locky-z/Curve-Tracer/2019/PIC/IMG_4324.JPG

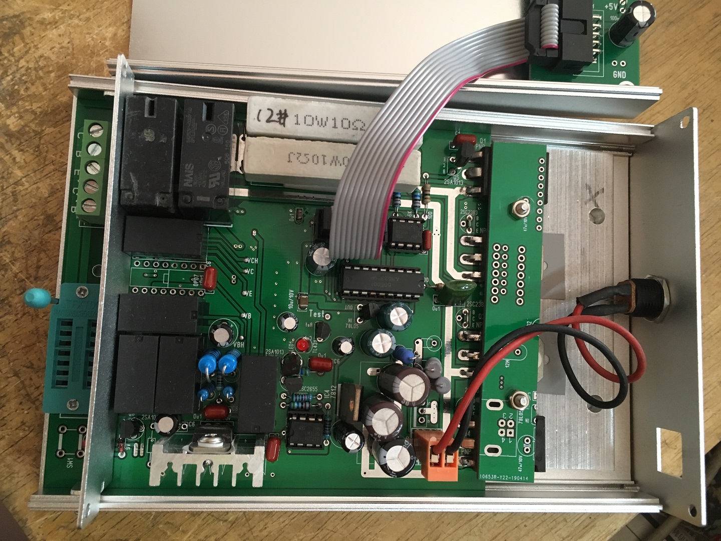
2019/PIC/IMG_4324.JPG
