locky-z/Curve-Tracer/2019/PIC/IMG_4323.JPG

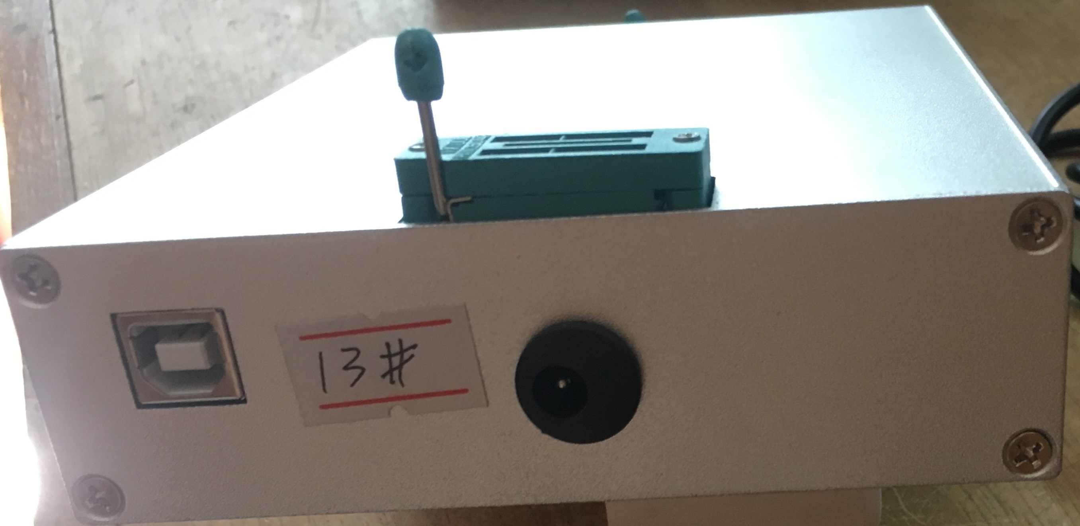
2019/PIC/IMG_4323.JPG
