locky-z/Curve-Tracer/2019/README

The 2019 version is same as the previous version, Performance and circuit are the same as previous versions.
2019 version make by SMD components and optimized the power consumption. 
2019 version remove the power supply and reduced shell size.
