locky-z/Curve-Tracer/2019/PCB/MCU(top).PNG

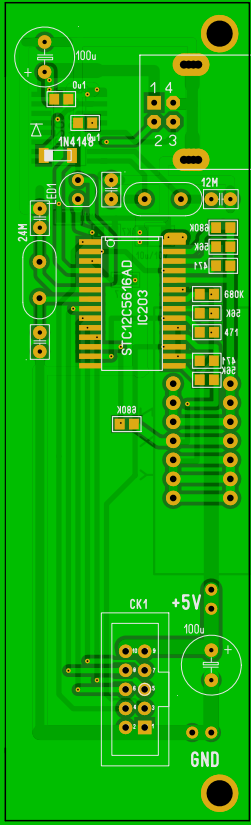
2019/PCB/MCU(top).PNG
