locky-z/Curve-Tracer/2019/PCB/power board(bottom).PNG

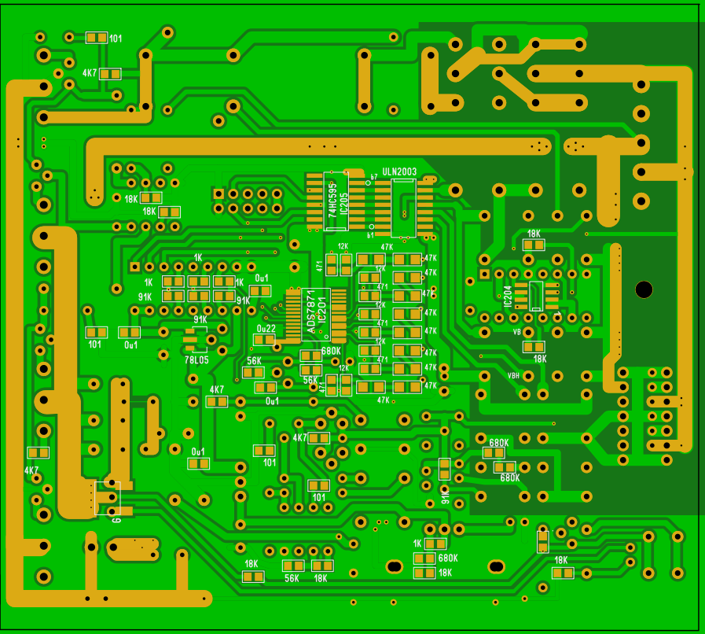
2019/PCB/power board(bottom).PNG
