locky-z/Curve-Tracer/2019/PCB/power board(top).PNG

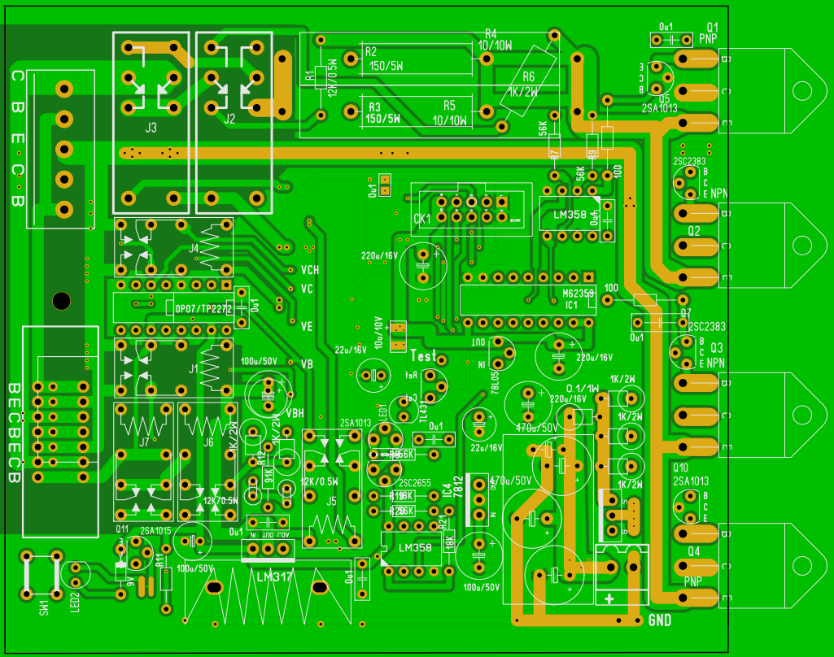
2019/PCB/power board(top).PNG
