locky-z/Curve-Tracer/2019/PIC/IMG_4321.JPG

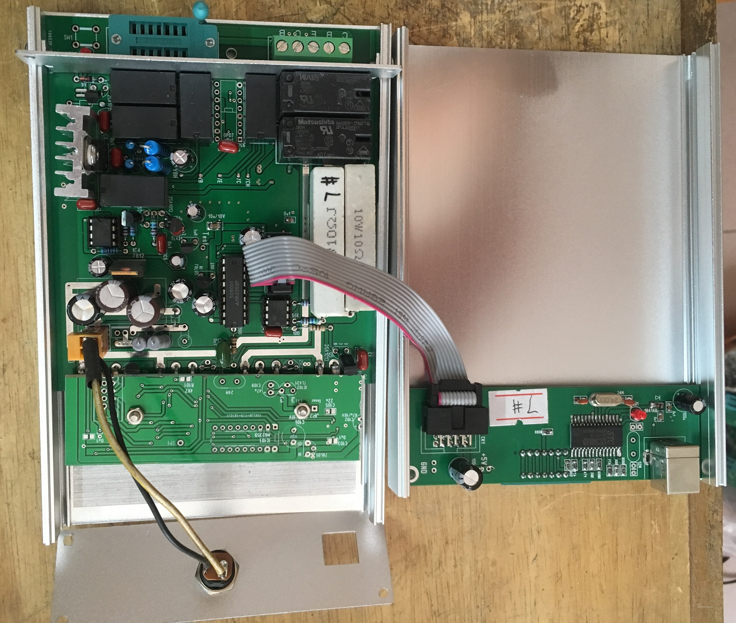
2019/PIC/IMG_4321.JPG
