locky-z/Curve-Tracer/2019/PIC/IMG_4322.JPG

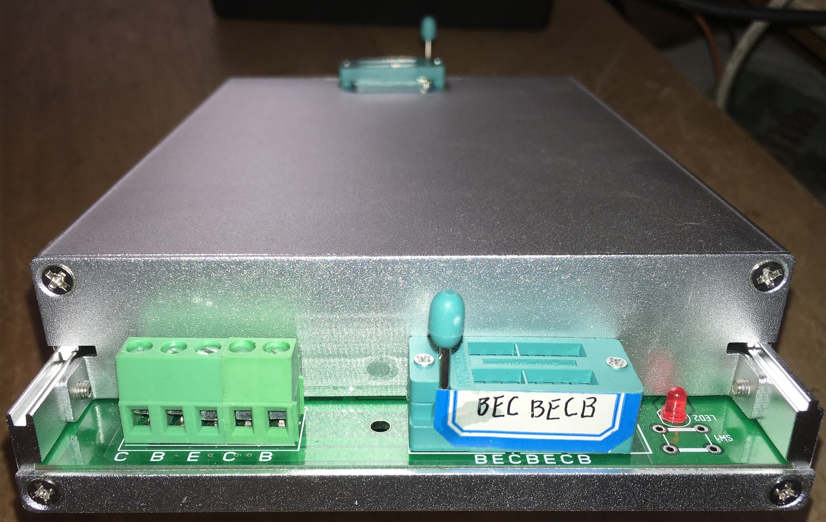
2019/PIC/IMG_4322.JPG
