locky-z/Curve-Tracer/2019/Sch/CT3-2019.png

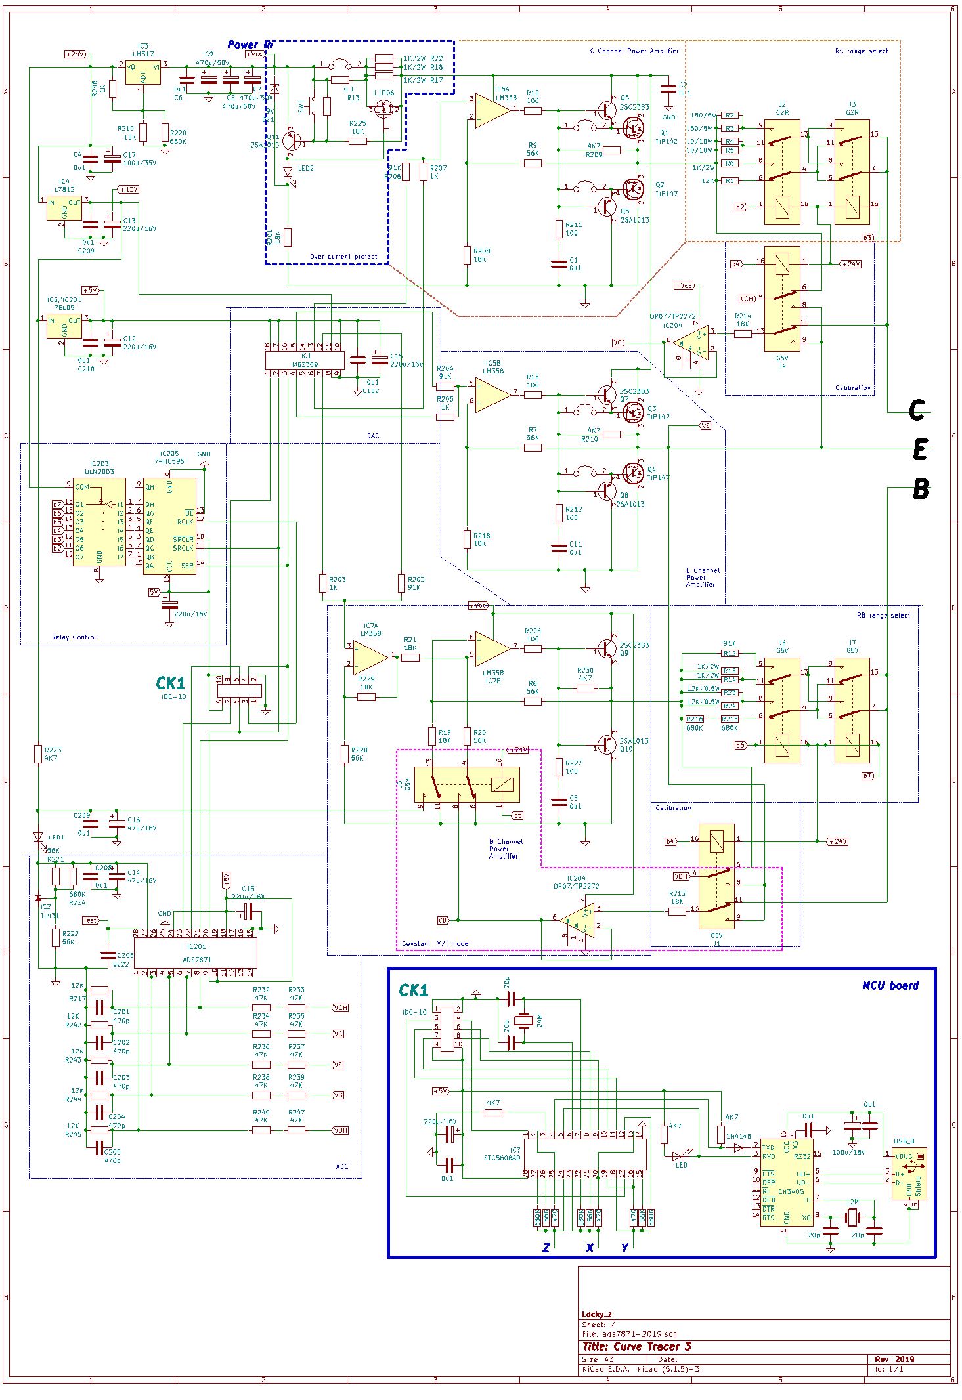
2019/Sch/CT3-2019.png
