locky-z/Curve-Tracer/Early version/IMG_20161015_153729.jpg

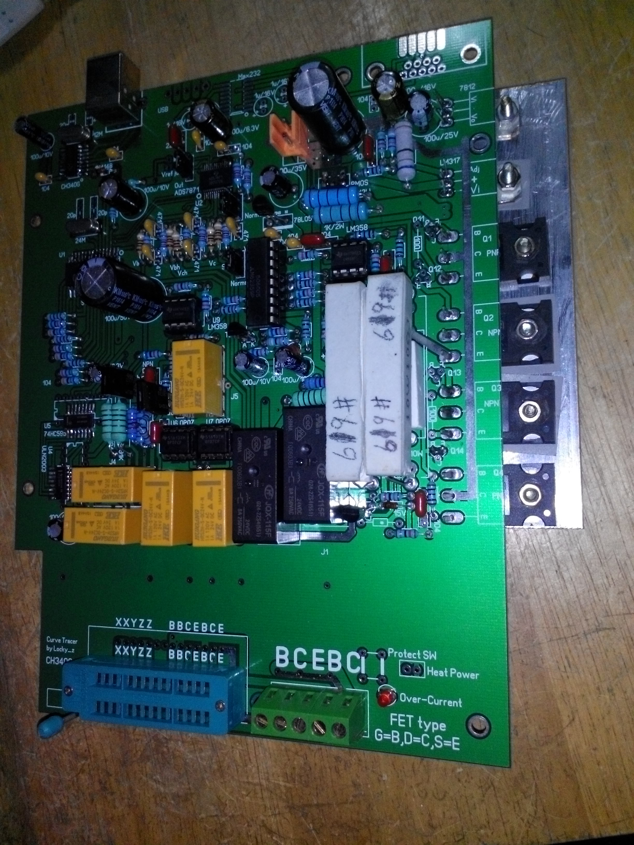
Early version/IMG_20161015_153729.jpg
