locky-z/Curve-Tracer/Early version/PCB.jpg

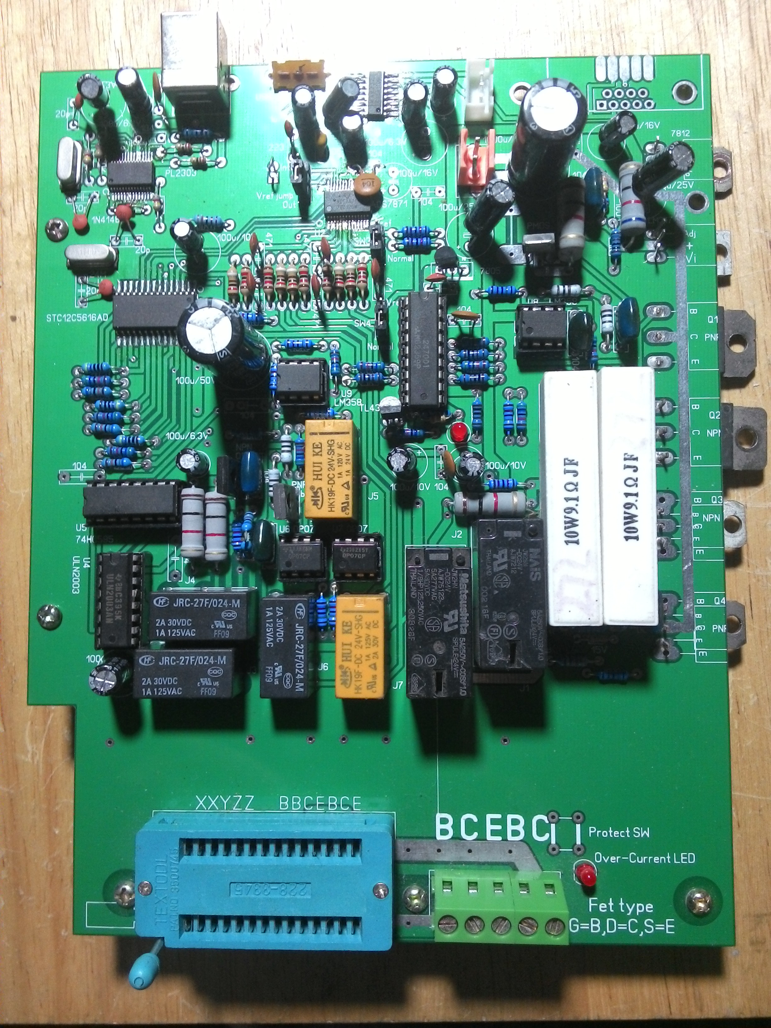
Early version/PCB.jpg
