locky-z/Curve-Tracer/(threads)

Thread 2 (2020-11-09):

Missing symbols in CT3-2019(KiCAD).sch which is provided in this repository.

snovotill, 2020-11-09:
Hello locky_z. The schematic **CT3-2019(KiCAD).sch** which is provided in this repository cannot be fully displayed because some of the needed symbols are only available in a private library named **CT3** which does not come with KiCad. Please see the attached exported KiCad schematic to see how the following components cannot be displayed: **IDC-10 CK1**, **M62359 IC1**, **ADS7871 IC201**, **STC5608AD IC?**.

Therefore I would like to request that that one of the following files be uploaded to this repository alongside the schematic **CT3-2019(KiCAD).sch** which is already provided here, so that it will display properly.
(1) Either the **cache.lib** which Eschema creates every time you edit and save the schematic.
(2) Or the private **CT3 library** which KiCad creates every time the schematic is edited and saved.

Thank you for this amazing curve tracer which I purchased from you in October.
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

locky-z, 2020-11-11:
Have upload kiCAD project file included lib.

Closed 2020-11-11.

Thread 3 (2020-11-09):

Error in schematic - Relay J1 pins are transposed with respect to PCB artwork

snovotill, 2020-11-09:
I had some trouble making a special calibration to my curve tracer because on the pin numbers of relay J1 are laterally transposed on the schematic and therefore do not correspond correctly to the PCB copper foil layer. I would have fixed this for you and submitted a pull request but the symbol library for the schematic missing in this repository (I opened a separate bug for this).

The affected pins are as follows: Pins 1, 4, 6 and 8 are transposed with pins 16, 13, 11 and 9. Fixing this in the schematic **CT3-2019(KiCAD).sch** will make it correspond properly with the actual PCB copper foil artwork.

Thread 4 (2020-11-09):

Updated silk screen desicgnations for relays J1 and J5.

snovotill, 2020-11-09:
The attached picture has been posted here so that people who have 2019 1st revision PCB's can see what the correct silkscreen designations are for J1 and J5, both of which are mislabelled as J4.
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
. I've also included the relay pin-out which is shown incorrectly in some of the documentation.

Thread 5 (2021-04-07):

请问测试软件是否有Mac或者linux平台的版本？

black373707314, 2021-04-07:
请问测试软件是否有Mac或者linux平台的版本？

locky-z, 2021-04-07:
原生mac和linux下的程序没有。
没试过能否在mac下运行。
有网友试过在linux的wine可以使用。

------------------&nbsp;原始邮件&nbsp;------------------
发件人:                                                                                                                        "locky-z/Curve-Tracer"                                                                                    ***@***.***&gt;;
发送时间:&nbsp;2021年4月7日(星期三) 下午2:44
***@***.***&gt;;
***@***.***&gt;;
主题:&nbsp;[locky-z/Curve-Tracer] 请问测试软件是否有Mac或者linux平台的版本？ (#5)

请问测试软件是否有Mac或者linux平台的版本？

—
You are receiving this because you are subscribed to this thread.
Reply to this email directly, view it on GitHub, or unsubscribe.
