locky-z/Curve-Tracer/2019/Sch/CT3-2019(KiCAD).sch

## KiCad design 2019/Sch/CT3-2019(KiCAD).sch (2020-01-28, last stored version)

Schematic: CT3-2019(KiCAD).sch

Parts:
C1, C2, C4, C5, C6, C11, C102, C208, C209, C210: 0u1
C7, C8, C9: 470u/50V
C12, C13, C15: 220u/16V
C14, C16: 47u/16V
C17: 100u/35V
C201, C202, C203, C204, C205: 470p
C206: 0u22
CK1: IDC-10
DZ1: 9V
IC1: M62359
IC2: TL431; TO-92_Inline
IC3: LM317
IC4: L7812
IC5, IC7: LM358; DFN-8-1EP_2x2mm_P0.5mm_EP1.05x1.75mm
IC6/IC201: 78L05
IC201: ADS7871
IC203: ULN2003
IC204: OP07/TP2272
IC205: 74HC595
J1, J4, J5, J6, J7: G5V; Relay_DPDT_Omron_G5V-2
J2, J3: G2R; Relay_DPDT_Omron_G5V-2
LED1, LED2: LED
Q1, Q3: TIP142; TO-220-3_Vertical
Q2, Q4: TIP147; TO-220-3_Vertical
Q5, Q7, Q9: 2SC2383
Q8, Q10: 2SA1013
Q11: 2SA1015
R1, R217, R242, R243, R244, R245: 12K
R2, R3: 150/5W
R4, R5: 10/10W
R6, R14, R15, R17, R18, R22: 1K/2W
R7, R8, R9, R20, R221, R222, R228: 56K
R10, R16, R211, R212, R226, R227: 100
R12, R202, R204, R206: 91K
R13: 0.1
R19, R21, R201, R208, R213, R214, R218, R219, R225, R229: 18K
R23, R24: 12K/0.5W
R203, R205, R207, R246: 1K
R209, R210, R223, R230: 4K7
R215, R216, R220, R224: 680K
R232, R233, R234, R235, R236, R237, R238, R239, R240, R247: 47K
SW1: SW_Push

Notes on the sheet:
MCU board
Power In
Over current protect
C Channel Power Amplifier
DAC
E Channel Power Amplifier
B Channel Power Amplifier
Constant V/I mode
ADC
Relay Control
Calibration
Calibration
RC range select
RB range select
